kareszklub/robert/design/frame/export/robert-Ball.stl

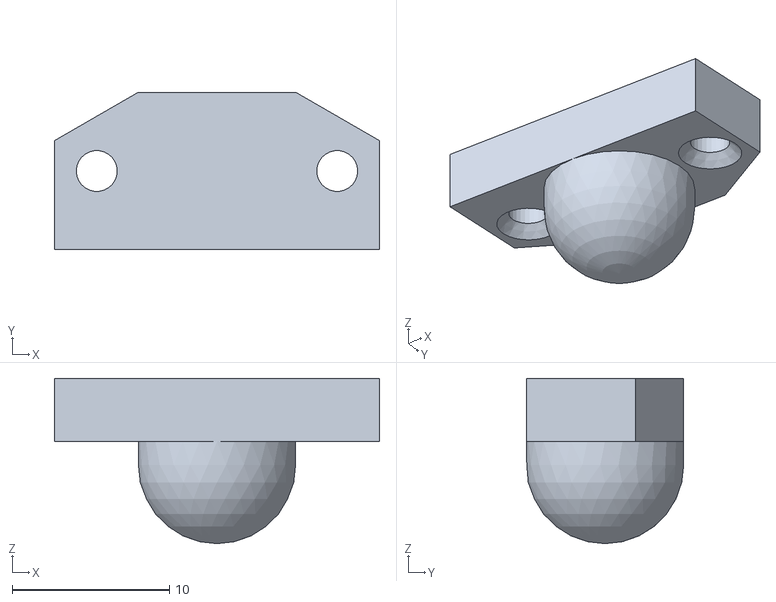
[picture p1: CAD file, 2026-09-20]
design/frame/export/robert-Ball.stl
20.6 x 10.0 x 10.5
