kareszklub/robert/design/frame/robert.FCStd

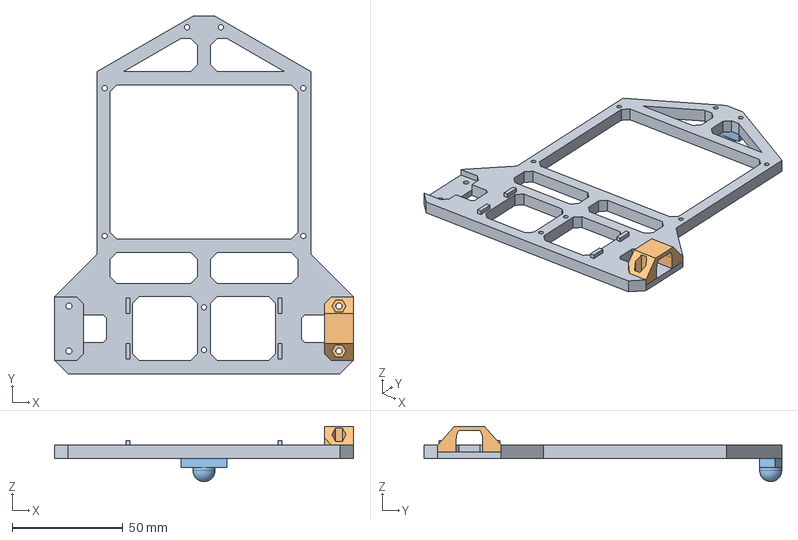
[picture p2: CAD file, 2026-09-20]
design/frame/robert.FCStd
135.0 x 161.4 x 25.0 mm
Frame
MotorBracket
Ball
