kareszklub/robert/design/frame/export/robert-Frame.stl

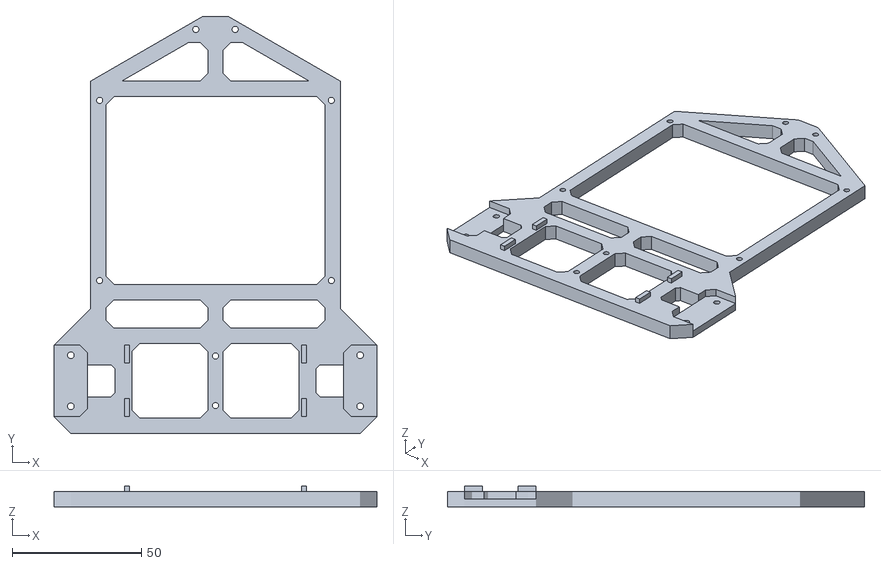
[picture p3: CAD file, 2026-09-20]
design/frame/export/robert-Frame.stl
125.0 x 161.4 x 8.00
