kareszklub/robert/design/frame/export/robert-MotorBracket.stl

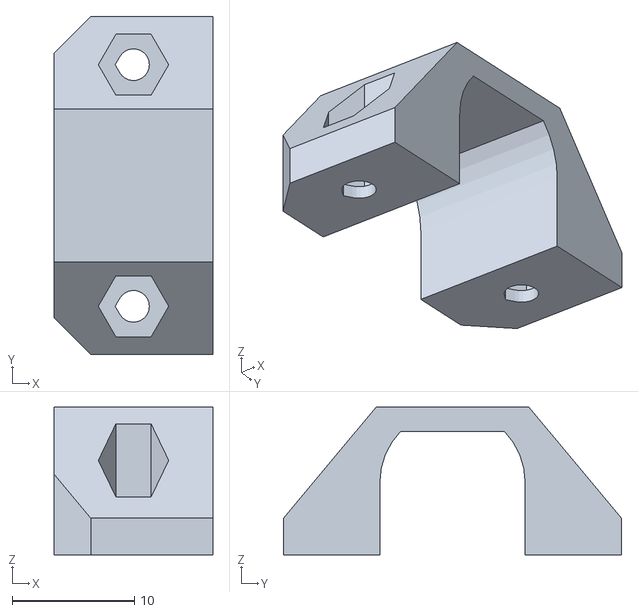
[picture p4: CAD file, 2026-09-20]
design/frame/export/robert-MotorBracket.stl
13.0 x 27.7 x 12.1
