kareszklub/robert/design/pcb/robert.kicad_pcb

## KiCad design design/pcb/robert.kicad_pcb (2026-09-22)

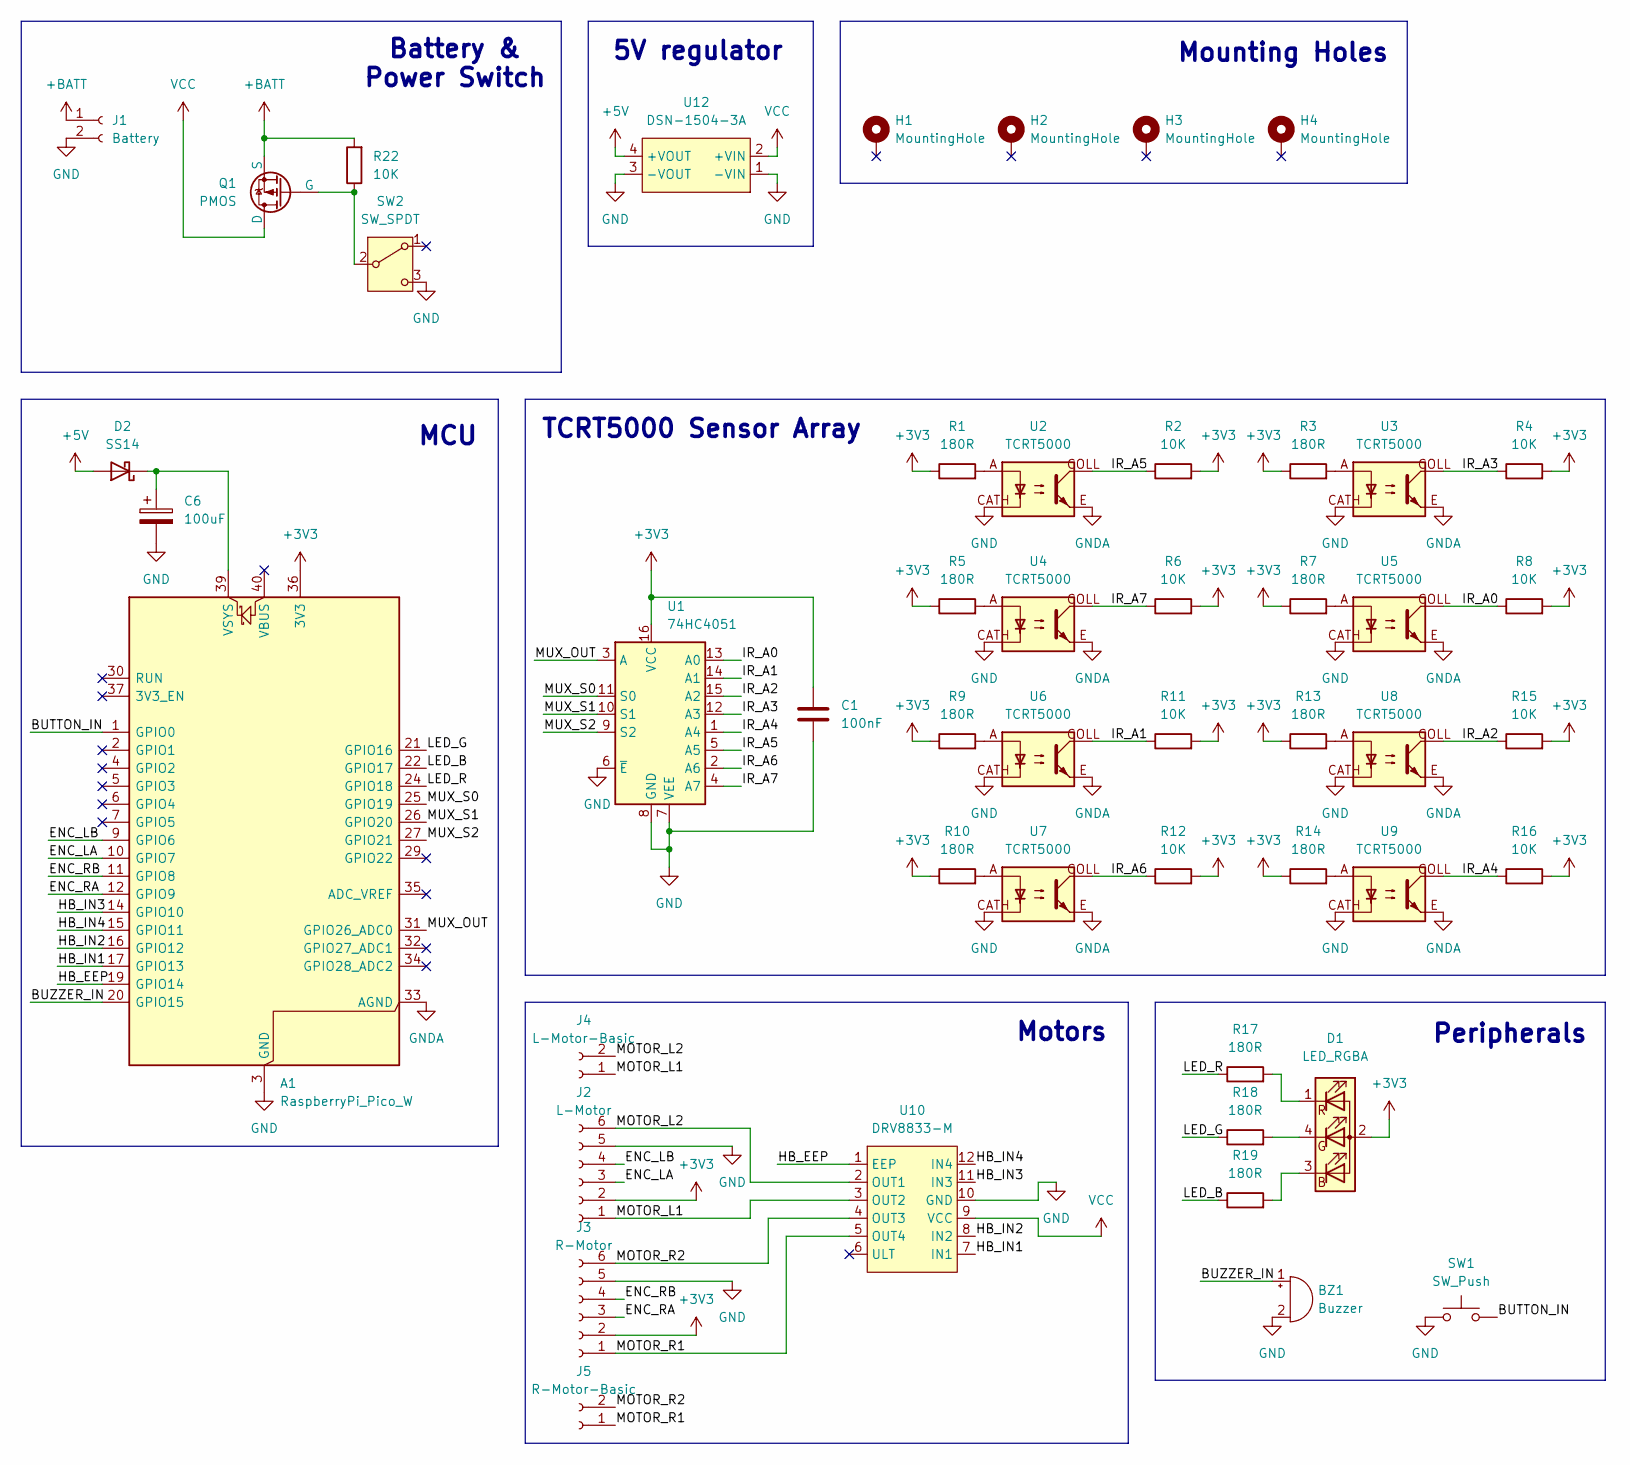
[picture p5: schematic robert.kicad_sch]

Parts:
A1: RaspberryPi_Pico_W; RaspberryPi_Pico_Common_THT
BZ1: Buzzer; Buzzer_TDK_PS1240P02BT_D12.2mm_H6.5mm
C1: 100nF; C_1206_3216Metric_Pad1.33x1.80mm_HandSolder
C6: 100uF; CP_Radial_D5.0mm_P2.00mm
D1: LED_RGBA; LED_D5.0mm-4_RGB
D2: SS14; D_SMA_Handsoldering
H1, H2, H3, H4: MountingHole; MountingHole_2.7mm_M2.5_DIN965_Pad
J1: Battery; JST_XH_B2B-XH-A_1x02_P2.50mm_Vertical
J2: L-Motor; JST_XH_B6B-XH-A_1x06_P2.50mm_Vertical
J3: R-Motor; JST_XH_B6B-XH-A_1x06_P2.50mm_Vertical
J4: L-Motor-Basic; JST_XH_B2B-XH-A_1x02_P2.50mm_Vertical
J5: R-Motor-Basic; JST_XH_B2B-XH-A_1x02_P2.50mm_Vertical
Q1: PMOS; TSOT-23_HandSoldering
R1, R3, R5, R7, R9, R10, R13, R14, R17, R18, R19: 180R; R_1206_3216Metric_Pad1.30x1.75mm_HandSolder
R2, R4, R6, R8, R11, R12, R15, R16, R22: 10K; R_1206_3216Metric_Pad1.30x1.75mm_HandSolder
SW1: SW_Push; SW_PUSH_6mm
SW2: SW_SPDT; PinHeader_1x03_P2.54mm_Vertical
U1: 74HC4051; DIP-16_W7.62mm
U2, U3, U4, U5, U6, U7, U8, U9: TCRT5000; tcrt5000
U10: DRV8833-M; DRV8833 Motor driver module
U12: DSN-1504-3A; DSN-1504 step-down module

Connections:
+3V3: A1.36 (3V3), C1.1, D1.2 (A), J2.2, J3.2, R1.1, R2.2, R3.1, R4.2, R5.1, R6.2, R7.1, R8.2, R9.1, R10.1, R11.2, R12.2, R13.1, R14.1, R15.2, R16.2, U1.16 (VCC)
+5V: D2.2 (A), U12.4 (+VOUT)
+BATT: J1.1, Q1.3 (S), R22.2
/BUTTON_IN: A1.1 (GPIO0), SW1.2
/BUZZER_IN: A1.20 (GPIO15), BZ1.1 (+)
/ENC_LA: A1.10 (GPIO7), J2.3
/ENC_LB: A1.9 (GPIO6), J2.4
/ENC_RA: A1.12 (GPIO9), J3.3
/ENC_RB: A1.11 (GPIO8), J3.4
/HB_EEP: A1.19 (GPIO14), U10.1 (EEP)
/HB_IN1: A1.17 (GPIO13), U10.7 (IN1)
/HB_IN2: A1.16 (GPIO12), U10.8 (IN2)
/HB_IN3: A1.14 (GPIO10), U10.11 (IN3)
/HB_IN4: A1.15 (GPIO11), U10.12 (IN4)
/IR_A0: R8.1, U1.13 (A0), U5.COLL
/IR_A1: R11.1, U1.14 (A1), U6.COLL
/IR_A2: R15.1, U1.15 (A2), U8.COLL
/IR_A3: R4.1, U1.12 (A3), U3.COLL
/IR_A4: R16.1, U1.1 (A4), U9.COLL
/IR_A5: R2.1, U1.5 (A5), U2.COLL
/IR_A6: R12.1, U1.2 (A6), U7.COLL
/IR_A7: R6.1, U1.4 (A7), U4.COLL
/LED_B: A1.22 (GPIO17), R19.1
/LED_G: A1.21 (GPIO16), R18.1
/LED_R: A1.24 (GPIO18), R17.1
/MOTOR_L1: J2.1, J4.1, U10.3 (OUT2)
/MOTOR_L2: J2.6, J4.2, U10.2 (OUT1)
/MOTOR_R1: J3.1, J5.1, U10.5 (OUT4)
/MOTOR_R2: J3.6, J5.2, U10.4 (OUT3)
/MUX_OUT: A1.31 (GPIO26_ADC0), U1.3 (A)
/MUX_S0: A1.25 (GPIO19), U1.11 (S0)
/MUX_S1: A1.26 (GPIO20), U1.10 (S1)
/MUX_S2: A1.27 (GPIO21), U1.9 (S2)
GND: A1.3 (GND), A1.8 (GND), A1.13 (GND), A1.18 (GND), A1.23 (GND), A1.28 (GND), A1.38 (GND), BZ1.2 (-), C1.2, C6.2, J1.2, J2.5, J3.5, SW1.1, SW2.3 (C), U1.6 (~E), U1.7 (VEE), U1.8 (GND), U2.CATH, U3.CATH, U4.CATH, U5.CATH, U6.CATH, U7.CATH, U8.CATH, U9.CATH, U10.10 (GND), U12.1 (-VIN), U12.3 (-VOUT)
GNDA: A1.33 (AGND), U2.E, U3.E, U4.E, U5.E, U6.E, U7.E, U8.E, U9.E
unnamed: A1.39 (VSYS), C6.1, D2.1 (K)
unnamed: D1.3 (BK), R19.2
unnamed: D1.4 (GK), R18.2
unnamed: D1.1 (RK), R17.2
unnamed: Q1.2 (G), R22.1, SW2.2 (B)
unnamed: R1.2, U2.A
unnamed: R3.2, U3.A
unnamed: R5.2, U4.A
unnamed: R7.2, U5.A
unnamed: R9.2, U6.A
unnamed: R10.2, U7.A
unnamed: R13.2, U8.A
unnamed: R14.2, U9.A
VCC: Q1.1 (D), U10.9 (VCC), U12.2 (+VIN)

Notes on the sheet:
5V regulator
TCRT5000 Sensor Array
Peripherals
Motors
MCU
Battery & Power Switch
Mounting Holes

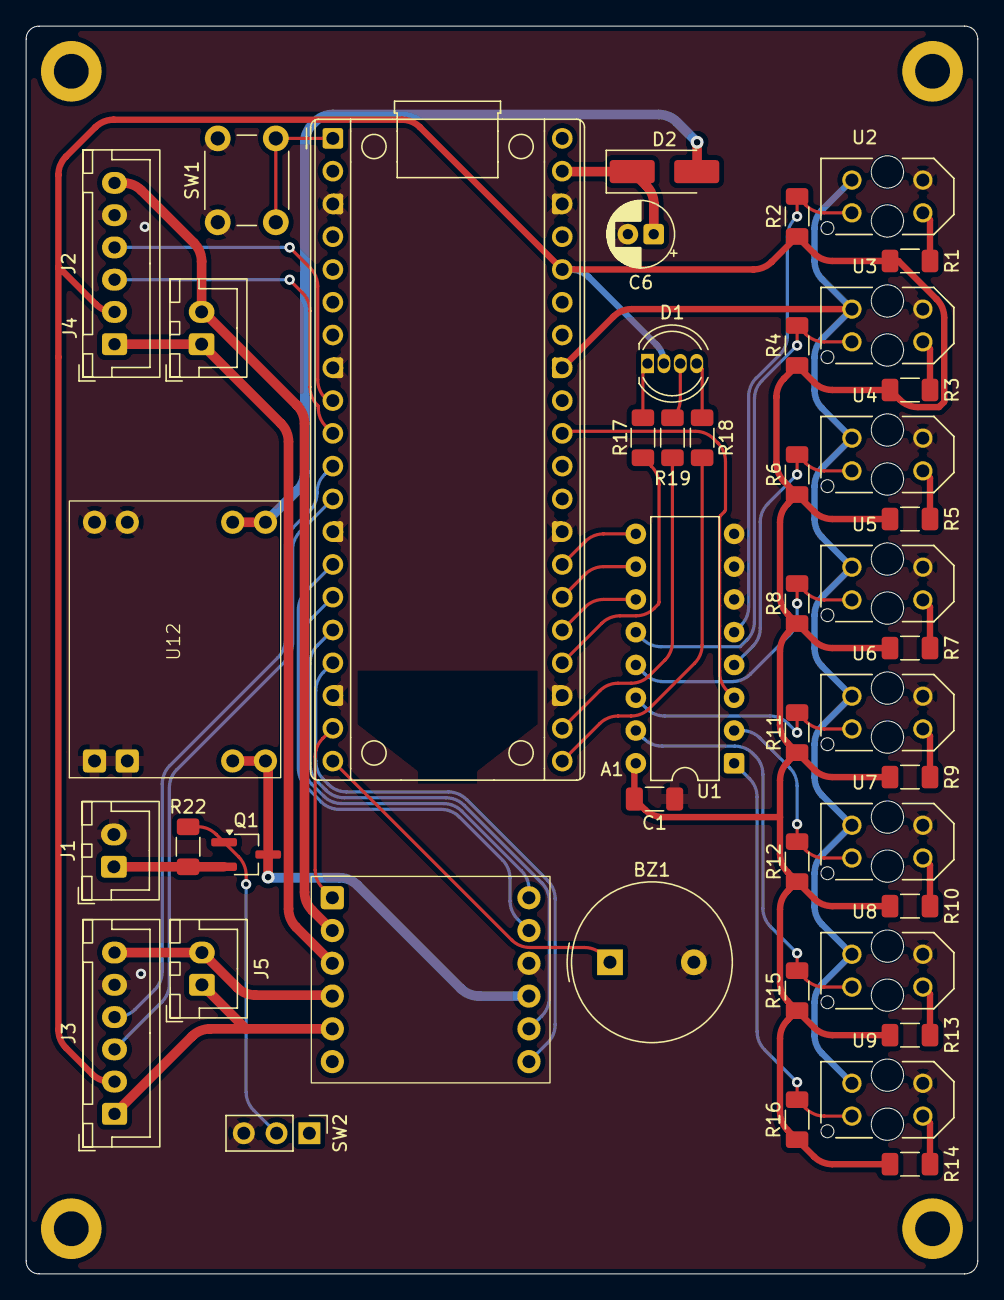
[picture p6: board robert.kicad_pcb from above]

Board: 2 copper layers, 73.8 x 96.7 mm, 49 parts (0 on the bottom side), 49 nets.
