kareszklub/robert/include/net_config.h

#include <cstdint>

namespace config {

constexpr char WIFI_SSID[] = "Asus18";
constexpr char WIFI_PASSWORD[] = "GyerekparaszT39";
constexpr uint32_t WIFI_TIMEOUT_MS = 30000;

constexpr char SERVER_IP[] = "192.168.50.132";
constexpr uint16_t SERVER_PORT = 8080;

} // namespace config
