kareszklub/robert/(commit log)

2026-09-20 Add 3D-printable frame files
    [robert-Ball.stl, robert-Frame.stl, robert-MotorBracket.stl, robert.FCStd]
2026-09-20 Add PCB files
    [robert.kicad_pcb, robert.kicad_sch]
2026-09-22 Add datasheet links, finalize PCB design
    [robert.kicad_pcb, robert.kicad_sch]
